Erhannis/minimal-rp2040-board/kicad/RP2040Breakout.kicad_pcb

## KiCad design kicad/RP2040Breakout.kicad_pcb (2023-08-14)

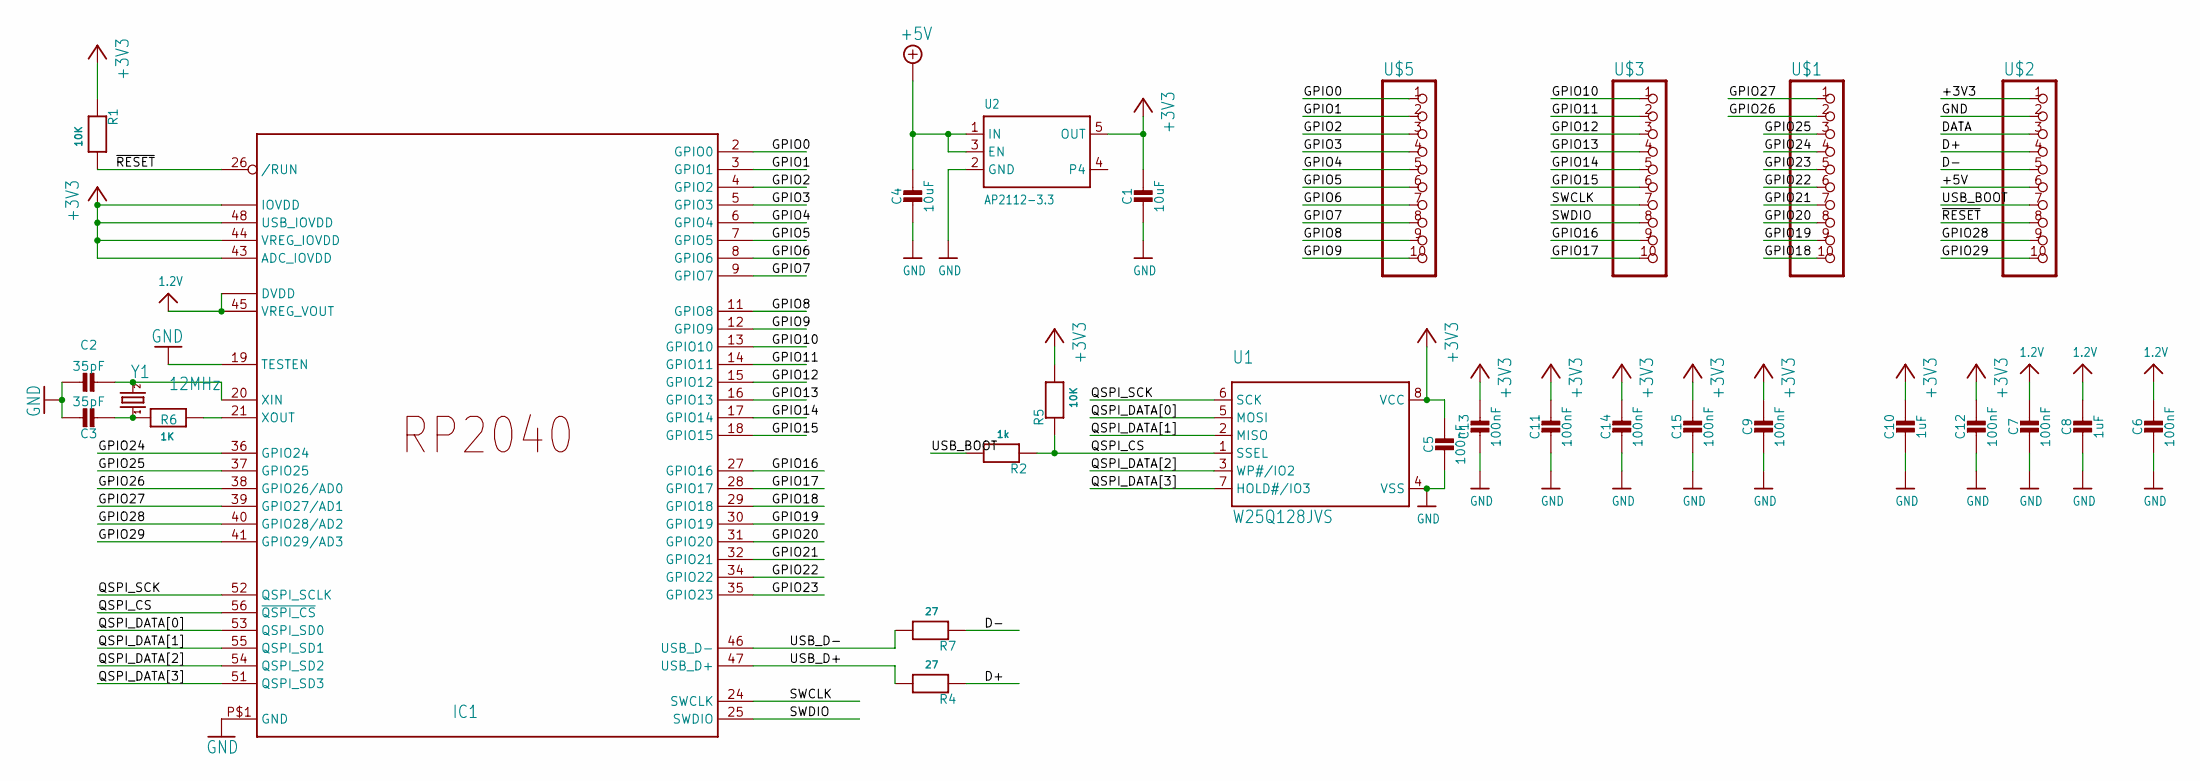
[picture p1: schematic RP2040Breakout.kicad_sch]

Parts:
C1, C4: 10uF; _0805MP; LCSC C1713
C2, C3: 35pF; _0402NO; LCSC C415391
C5, C6, C7, C9, C11, C12, C13, C14, C15: 100nF; _0402NO; LCSC C1525
C8, C10: 1uF; _0402NO; LCSC C14445
IC1: RP2040_QFN56; QFN56_7MM_REDUCEDEPAD; LCSC C2040
R1, R5: 10K; _0402NO; LCSC C60490
R2: 1k; _0402NO; LCSC C140196
R4, R7: 27; _0402NO; LCSC C25100
R6: 1K; _0402NO; LCSC C140196
U1: W25Q128JVS; SOIC8_208MIL; LCSC C97521
U2: AP2112-3.3; SOT23-5@1; LCSC C51118
U$1, U$2, U$3, U$5: HEADER-1X10ROUND; 1X10_ROUND
Y1: 12MHz; CRYSTAL-SMD-5X3; LCSC C362359

Connections:
1.2V: C6.1, C7.1, C8.1, IC1.23 (DVDD), IC1.45 (VREG_VOUT), IC1.50 (DVDD)
+3V3: C1.1, C5.1, C9.1, C10.1, C11.1, C12.1, C13.1, C14.1, C15.1, IC1.1 (IOVDD), IC1.10 (IOVDD), IC1.22 (IOVDD), IC1.33 (IOVDD), IC1.42 (IOVDD), IC1.43 (ADC_IOVDD), IC1.44 (VREG_IOVDD), IC1.48 (USB_IOVDD), IC1.49 (IOVDD), R1.1, R5.2, U1.8 (VCC), U2.5 (OUT), U$2.1
+5V: C4.1, U2.1 (IN), U2.3 (EN), U$2.6
/D+: R4.1, U$2.4
/D-: R7.1, U$2.5
/DATA: U$2.3
/GPIO0: IC1.2 (GPIO0), U$5.1
/GPIO1: IC1.3 (GPIO1), U$5.2
/GPIO2: IC1.4 (GPIO2), U$5.3
/GPIO3: IC1.5 (GPIO3), U$5.4
/GPIO4: IC1.6 (GPIO4), U$5.5
/GPIO5: IC1.7 (GPIO5), U$5.6
/GPIO6: IC1.8 (GPIO6), U$5.7
/GPIO7: IC1.9 (GPIO7), U$5.8
/GPIO8: IC1.11 (GPIO8), U$5.9
/GPIO9: IC1.12 (GPIO9), U$5.10
/GPIO10: IC1.13 (GPIO10), U$3.1
/GPIO11: IC1.14 (GPIO11), U$3.2
/GPIO12: IC1.15 (GPIO12), U$3.3
/GPIO13: IC1.16 (GPIO13), U$3.4
/GPIO14: IC1.17 (GPIO14), U$3.5
/GPIO15: IC1.18 (GPIO15), U$3.6
/GPIO16: IC1.27 (GPIO16), U$3.9
/GPIO17: IC1.28 (GPIO17), U$3.10
/GPIO18: IC1.29 (GPIO18), U$1.10
/GPIO19: IC1.30 (GPIO19), U$1.9
/GPIO20: IC1.31 (GPIO20), U$1.8
/GPIO21: IC1.32 (GPIO21), U$1.7
/GPIO22: IC1.34 (GPIO22), U$1.6
/GPIO23: IC1.35 (GPIO23), U$1.5
/GPIO24: IC1.36 (GPIO24), U$1.4
/GPIO25: IC1.37 (GPIO25), U$1.3
/GPIO26: IC1.38 (GPIO26/AD0), U$1.2
/GPIO27: IC1.39 (GPIO27/AD1), U$1.1
/GPIO28: IC1.40 (GPIO28/AD2), U$2.9
/GPIO29: IC1.41 (GPIO29/AD3), U$2.10
/QSPI_CS: IC1.56 (~QSPI_CS), R2.1, R5.1, U1.1 (SSEL)
/QSPI_DATA[0]: IC1.53 (QSPI_SD0), U1.5 (MOSI)
/QSPI_DATA[1]: IC1.55 (QSPI_SD1), U1.2 (MISO)
/QSPI_DATA[2]: IC1.54 (QSPI_SD2), U1.3 (WP#/IO2)
/QSPI_DATA[3]: IC1.51 (QSPI_SD3), U1.7 (HOLD#/IO3)
/QSPI_SCK: IC1.52 (QSPI_SCLK), U1.6 (SCK)
/SWCLK: IC1.24 (SWCLK), U$3.7
/SWDIO: IC1.25 (SWDIO), U$3.8
/USB_BOOT: R2.2, U$2.7
/USB_D+: IC1.47 (USB_D+), R4.2
/USB_D-: IC1.46 (USB_D-), R7.2
/~RESET: IC1.26 (/RUN), R1.2, U$2.8
GND: C1.2, C2.1, C3.1, C4.2, C5.2, C6.2, C7.2, C8.2, C9.2, C10.2, C11.2, C12.2, C13.2, C14.2, C15.2, IC1.19 (TESTEN), IC1.P$1 (GND), U1.4 (VSS), U2.2 (GND), U$2.2
unnamed: C3.2, R6.1, Y1.1
unnamed: C2.2, IC1.20 (XIN), Y1.3 (2)
unnamed: IC1.21 (XOUT), R6.2

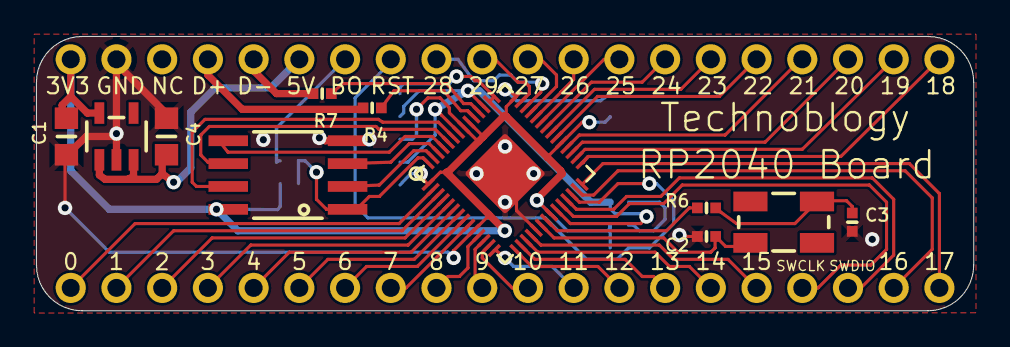
[picture p2: board RP2040Breakout.kicad_pcb from above]

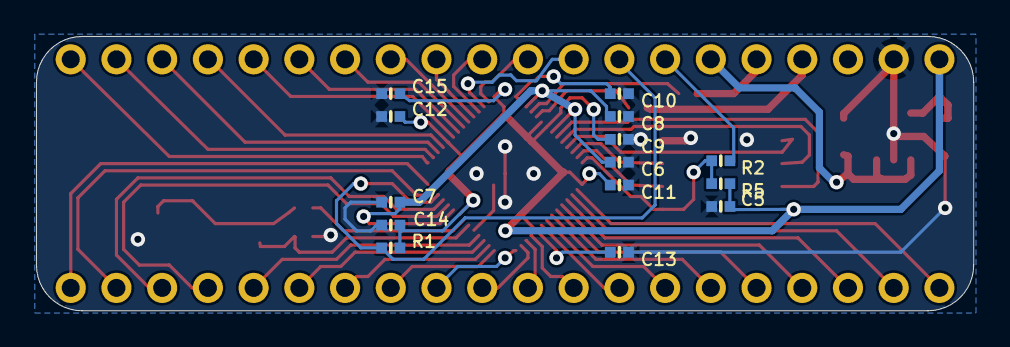
[picture p3: board RP2040Breakout.kicad_pcb from below]

Board: 2 copper layers, 52.1 x 15.2 mm, 29 parts (14 on the bottom side), 51 nets.
