Erhannis/minimal-rp2040-board/(commit log)

2023-08-07 Ok, I imported into kicad and also assigned JLCPCB part numbers
    [RP2040Breakout.kicad_pcb, RP2040Breakout.kicad_sch]
2023-08-07 Updated pcb footprints from schematic; fingers crossed
    [RP2040Breakout.kicad_pcb]
2023-08-07 Oh, zones, right
    [RP2040Breakout.kicad_pcb]
2023-08-07 Ok, I ordered some from JLCPCB, guess we'll see how it goes.
    [bom.csv, designators.csv, positions.csv]
2023-08-07 There were 'unsaved changes' to the pcb, dunno what that's about
2023-08-14 Ooookay. So aside from the misunderstanding about capacitors, somehow the import process removed a single important trace. ...As far as I can tell. Namely, the GND connection for the voltage regulato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
    [RP2040Breakout.kicad_pcb, RP2040Breakout.kicad_sch]
